shabaz123/waveminer/README.md

Wave Miner
==========

This repository contains the schematic, PCB Gerber files, bill of materials and code for the Wave Miner Digital Signal Processor (DSP) board, which connects to the Raspberry Pi (Pi 4 was tested; other versions can work with a small code change; the addresses called PERIPHERAL_BASE or I2C_BASE in the i2cfunc.h file needs to be modified if you're not using a Pi 4).

For simplicity this project uses a ready-made low-cost (about $20 USD) DSP module from AliExpress, it is the green board on the left in the photo below. The remainder parts and blue circuit board should cost less than $30, and assembly time is just a few hours. It can be assembled using a basic soldering iron (it is all through-hole soldering mostly, and a few large surface-mount parts that need no special tools).

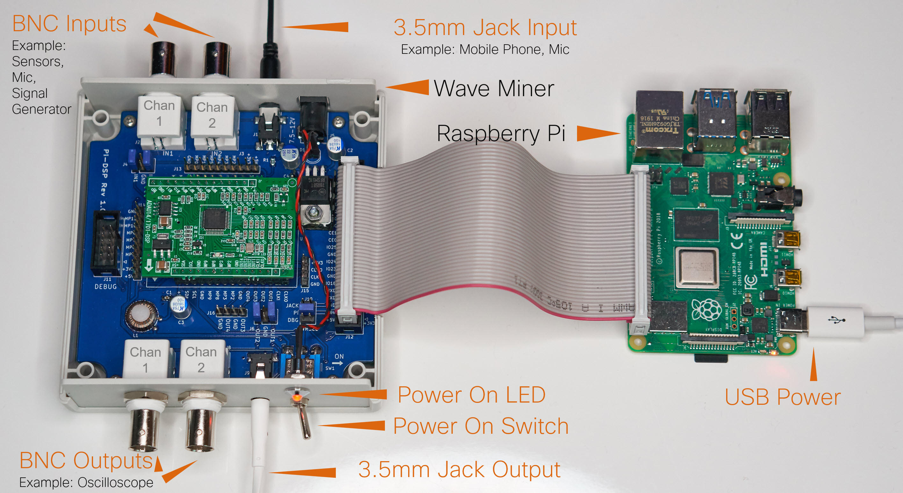
[picture p1: assets/waveminer-pi-annotated.jpg]


What are some example use-cases for it?
---------------------------------------

Use Wave Miner for examinining signals from sensors (vibration sensors, microphones etc), measuring them and cleaning them up. Wave Miner is low-cost enough that it could be permnanently installed for a particular use-case (e.g. constantly processing sensor signals) or it can be used as an instrument for evaluating new sensor data and deciding how to work with it. You can also use Wave Miner to generate signals, including noise, in order to simulate scenarios, or generate tones or other signals for other project development purposes. Since Wave Miner can handle the audio spectrum range, Wave Miner can also be used for audio effects and processing. Use Wave Miner for pulling weak signals out of noise using lock-in amplifier capability, or use Wave Miner to make impedance measurements.

What can you do with the Wave Miner?
------------------------------------

Here are some examples; all of these are possible with the hardware and software. Reboot the Wave Miner card (toggle the power button left and then right) after using the **eeload** command:

(1) Sine Wave Generation at (say) 1000 Hz, with an amplitude of 1.0 (1.0 corresponds to 2.6 Vp-p):

    ./eeload -p tone_app.bin
    ./dspgen -f 1000 -a 1.0

(2) Notch filter at (say) 50 Hz:

    ./eeload -p notch4.bin
    ./notch -n 50

(3) Bandpass filter a signal, between 300 Hz and 3000 Hz:

    ./eeload -p filter6.bin
    ./filter -b1 300 -b2 3000

(4) High-pass filter a signal, at 60 Hz:

    ./eeload -p filter6.bin
    ./filter -h 60

(5) Low-pass filter a signal, at 500 Hz:

    ./eeload -p filter6.bin
    ./filter -l 500

(6) Very experimental lock-in amplifier, to identify weak signals

    ./eeload -p lia.bin

The stimulus signal is generated at Output channel 1, and the input is at the channel 1 input connection. The lock-in amplifier result is a tone output for now, audible on output channel 2. The tone increases as the signal is detected by the lock-in amplifier.

(7) Frequency response and RMS measurements:

    ./eeload -p freqresp.bin
    
and

    ./eeload -p rms.bin

See the [webdsp project](https://github.com/shabaz123/webdsp) which uses the Wave Miner hardware. It describes how to view the frequency response and RMS values on a web page.

(8) Impedance Measurement at 1000 Hz (frequency selection #3) using display mode #1 (parallel Rp Rc)

    ./eeload -p imp.bin
    ./imp -i 3 -d 1

The impedance measurement software currently only supports 100, 120, 1000 and 10000 Hz (selected using -i1 to -i4 respectively) and one display mode (selected using -d 1). The stimulus signal is generated on the first output port on the Wave Miner, and the measurement is made on the first and second input ports (in-phase real, and 90 degree out-of-phase imaginary respectively). External hardware may be required to buffer the stimulus and to amplify the measurement signals, depending on the range of impedance to be measured. Currently there is no calibration capability, so some values in the code may need to be adjusted. 

Example output:

    pi@raspberrypi:~/development/waveminer$ ./imp -i 3 -d 1 -m
    Phase               (phi) : -0.494 rad
    Impedance             (Z) : 8.248 ohm
    Reactance             (X) : -4.443 ohm
    Resistance            (R) : 6.948 ohm
    Parallel Resistance  (Rp) : 9.369 ohm
    Parallel Capacitance (Cp) : 9.153 uF    

Ordering the PCB
----------------

The zip file prefixed **export-gerber-pi-dsp** can be uploaded to popular PCB manufacturer sites such as JLC PCB or Elecrow, for an instant quote. It shouldn't cost more than about $5 (not including shipping charges). NOTE: It's recommended to use the latest export-gerber-pi-dsp-rev1_1.zip file, not the older file. There are three main differences: (1) A pin header is added for forcing the EEPROM to be Write-Enabled; this is useful when using an external EVAL-ADUSB2EBZ debug tool; you can leave the jumper removed if you're not using that. (2) cleaned up the top-layer copper fill slightly, (3) Improved the silkscreen with larger text. The schematic and bill of materials is not modified, since the only addition is the optional 2-way pin header and jumper, which, as mentioned, are only needed if you plan to use the external debug too.

Ordering the Components
-----------------------

See the wave-miner **bill-of-materials** PDF file for the parts list. A few parts (particularly the DSP board) are available from AliExpress, and the remainder can be obtained from sources such as Farnell/Newark. It is recommended that a ribbon cable with connectors pre-assembled for the Raspberry Pi is purchased from (say) Adafruit, unless you're familiar with how to attach insulation displacement connectors (IDC) to the ribbon cable. Note that the cable is essential, it is not possible to plug the board directly on top of the Pi like 'Pi HAT' cards.

It is also useful to have one BNC-to-BNC cable, and one cable with stereo 3.5mm plug on each end, for experimenting with the Wave Miner.

You will also need a Raspberry Pi. A Pi 4 was tested. It is possible to use a Pi 3 variant, but a code change will be required. No code change is needed if a Pi 4 is being used.

Building the Wave Miner
-----------------------

Nearly all parts are through-hole, so it is easy to solder, since the main part (the DSP module) is ready-made. The few surface mount parts are large and mostly optional. The ferrite choke is hand-wound, but if you don't have the parts (ferrite core and ~ 0.2mm diameter enamelled copper wire) then you could just put a wire short on the PCB.

Plug four jumpers to allow the two channels of input and two channels of output signals to get to the connectors. Plug a fifth jumper to select the power source (for instance select the Pi setting, so that the Pi powers the Wave Miner board).

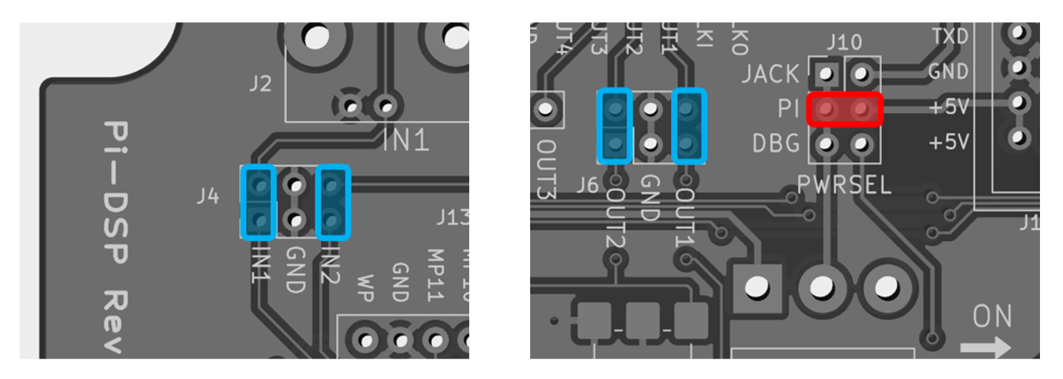
[picture p2: assets/pi-dsp-jumpers.png]


Connecting the Wave Miner to the Pi
-----------------------------------

With both the Wave Miner board and the Pi Unpowered, connect the ribbon cable between the Wave Miner and the Pi. You can plug the jumper into the Wave Miner so that the board will be powered from the Pi. Now you can power up the Pi.

Pi Pre-Requisites
-----------------

If you don't have a user account called **pi** (some recent Pi OS builds no longer have a pi user by default) then create a pi user account before proceeding, because some paths in the code are hard-coded for the pi user. You can manually modify the paths, but it is easier to just use a pi user for now.

Ensure, by typing **raspi-config** in a command prompt, that the **I2C** capability on the Pi is enabled. 

Installing the Code
-------------------

The **waveminer** software contains lots of utilities/applications.

Once you have completed the **Pi Pre-Requisites** steps above, type the following on the Pi in a command prompt to install the waveminer software:

    mkdir -p ~/development
    cd ~/development
    git clone https://github.com/shabaz123/waveminer.git
    cd waveminer
    make

Testing It
----------

You can test that the setup is working fine by running an example application:

Switch on the Wave Miner by flicking the toggle switch to the right, which is the **on** position. Then plug in headphones into the front 3.5mm stereo connector.

Type the following in a command prompt on the Pi:

    cd ~development/waveminer
    ./eeload -p tone_app.bin

Reboot the Wave Miner for the code to take effect. To perform the reboot, flick the toggle switch off and on.

Now type the following, and you should hear a continuous 220 Hz tone from the left earpiece:

    ./dspgen -a 0.1 -f 220

If you don't hear anything, you can increase the volume by increasing the **-a** parameter:

    ./dspgen -a 0.4 -f 220

Next Steps
----------

There are some partner web apps for the Wave Miner, to allow you to operate the Wave Miner directly from a web browser.

To install and use the web apps, visit https://github.com/shabaz123/webdsp

When run, the web apps will automatically call the Wave Miner code.

Creating Custom Apps
--------------------

To create your own custom DSP apps, install free-to-use SigmaStudio software. SigmaStudio uses graphical programming. 

The SigmaStudio Automotive and Generic Release SigmaStudio 64 Bit-OS Rev 4.6 is available from the [Analog Devices](https://www.analog.com/en/design-center/evaluation-hardware-and-software/software/ss_sigst_02.html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) website.

Use the software to drag-and-drop to build up the following Hardware Configuration:

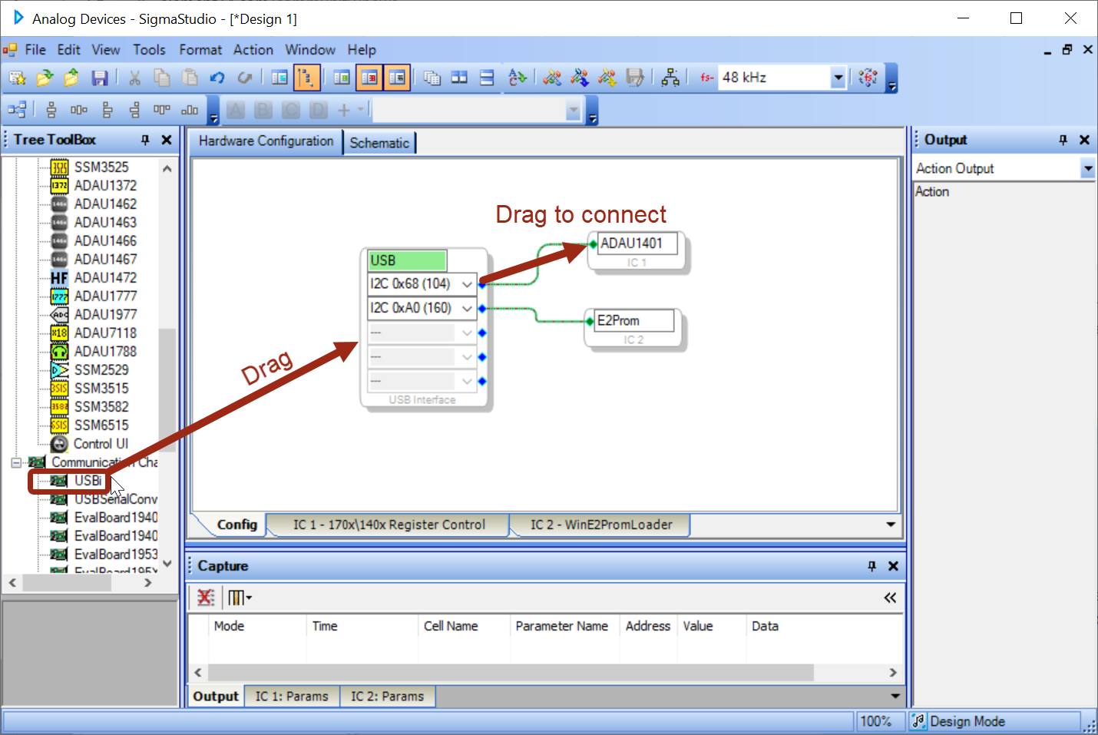
[picture p3: assets/sigma-drag.png]


Next, click on the Schematic tab and construct your desired siganl flow, again using drag-and-drop. Here is an example to generate a sine wave with configurable amplitude:

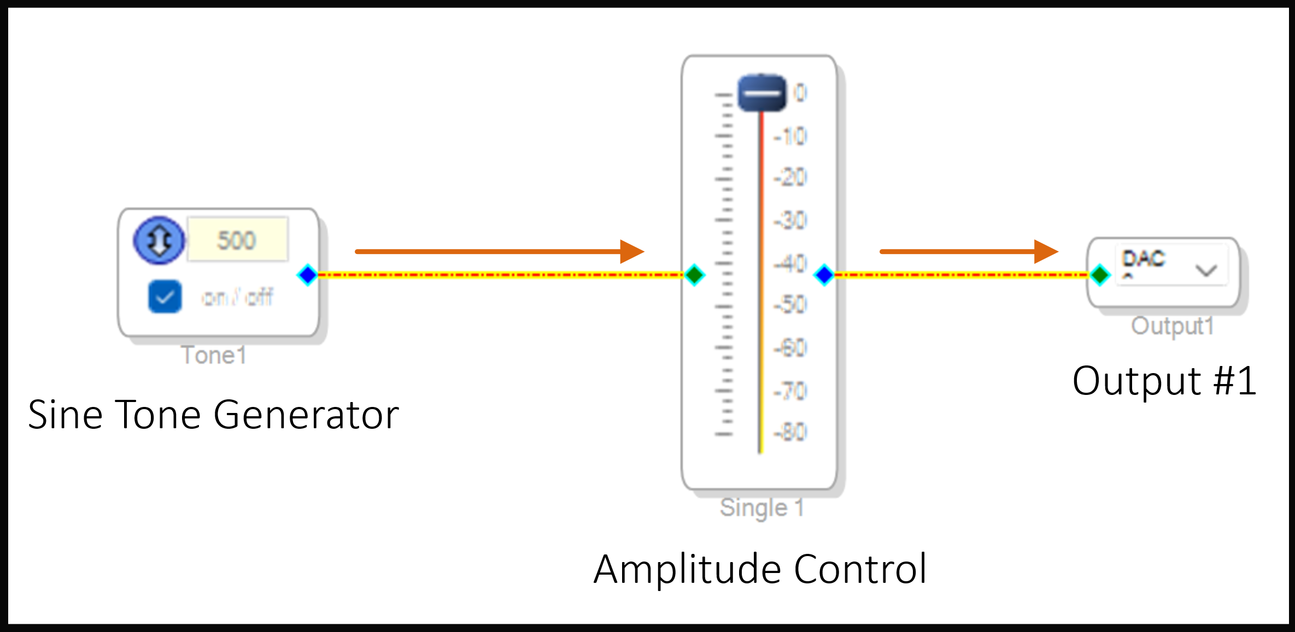
[picture p4: assets/dspgen-flow.png]


Click on the icon shown here, which is the **Link Compile Download** icon:

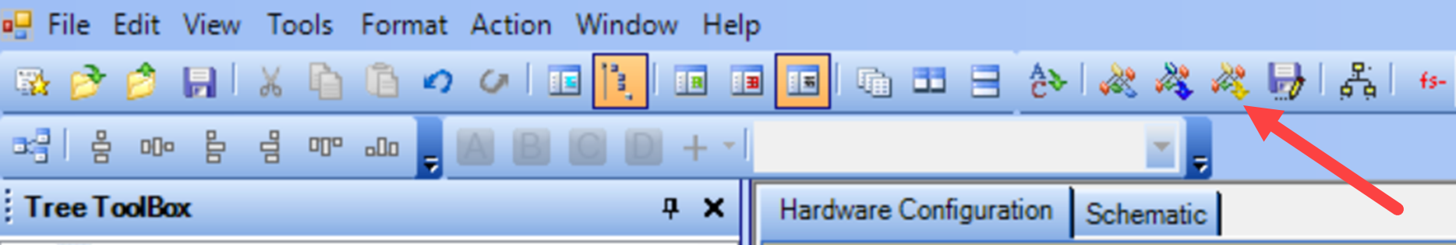
[picture p5: assets/lcc-icon.png]


You will get an error message concerning absence of USB programmer tool, but you can ignore the error. Now click back to the Hardware Configuration pane, and right-click on the ADAU1401 component which was drag-and-dropped earlier, and select **Write Latest Compilation to E2PROM**

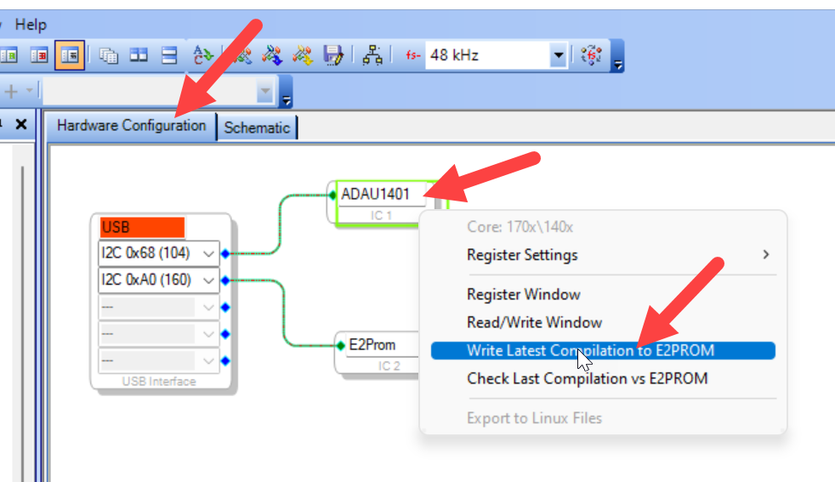
[picture p6: assets/write-eeprom.png]


Now go into the project folder, and there will be a sub-folder inside there called **xyz_IC 2** where xyz is your project name. The firmare file will be there, called **E2prom.bin**. That file can be transferred to the Pi, renamed to something more memorable, and then you can use the **eeload -p** command as shown in the examples earlier.

If you wish to use the Pi to configure the elements in the graphical flow, then click on the item in SigmaStudio and make any example modification to it, for instance change the frequency displayed inside the sine tone generation box. You should see a stream of hex bytes displayed in the lower pane in Sigma Studio; those bytes are the values that need to be sent using I2C. Refer to the **dsputil.cpp** file to see how this is done. 

Appendix 1: Using I2S Output
---------------------------------------

If you don't wish to use the analog output, and prefer digital I2S output, then you can use the pin headers and connect as follows: MP6=DATA, MP10=LRCLK, MP11=BCLK. The Sigmal Studio hardware configuration looks like this:

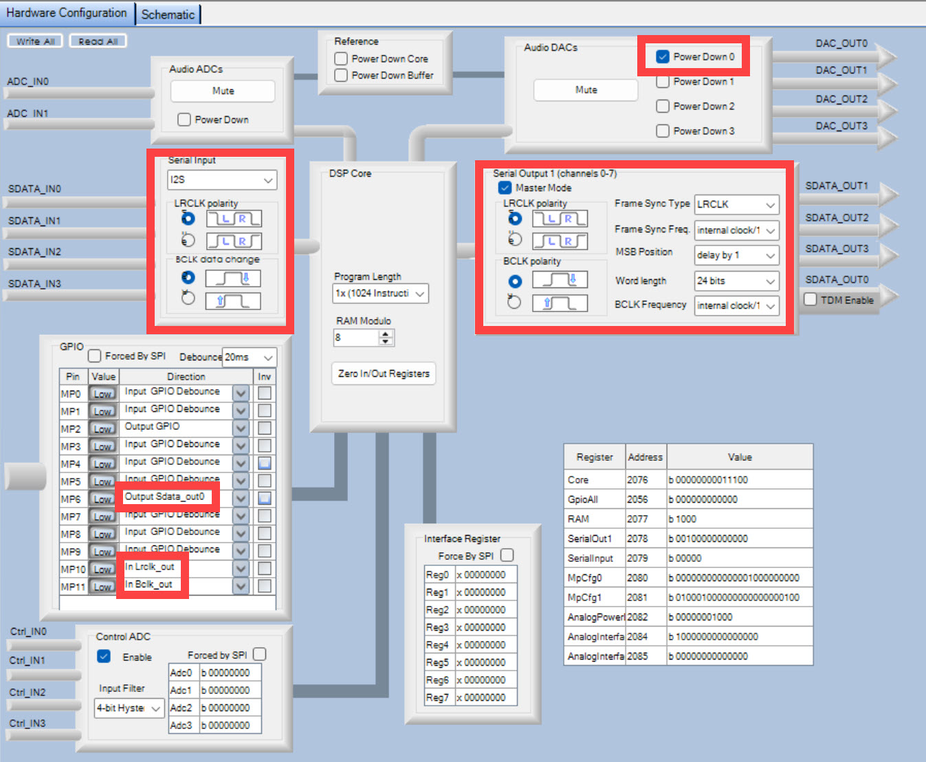
[picture p7: assets/dsp-hw-config-i2s-out.jpg]


For the DSP flow, use the output sink shown in the diagram here:

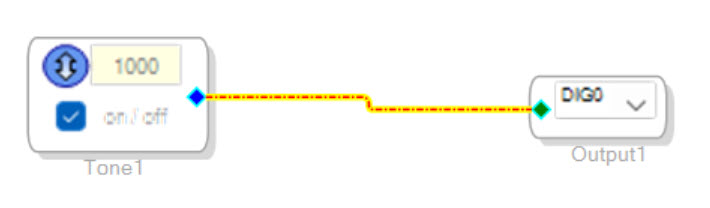
[picture p8: assets/dsp-flow-i2s-out.jpg]
