shabaz123/waveminer/wave-miner-rev-1-panel-cutouts.pdf

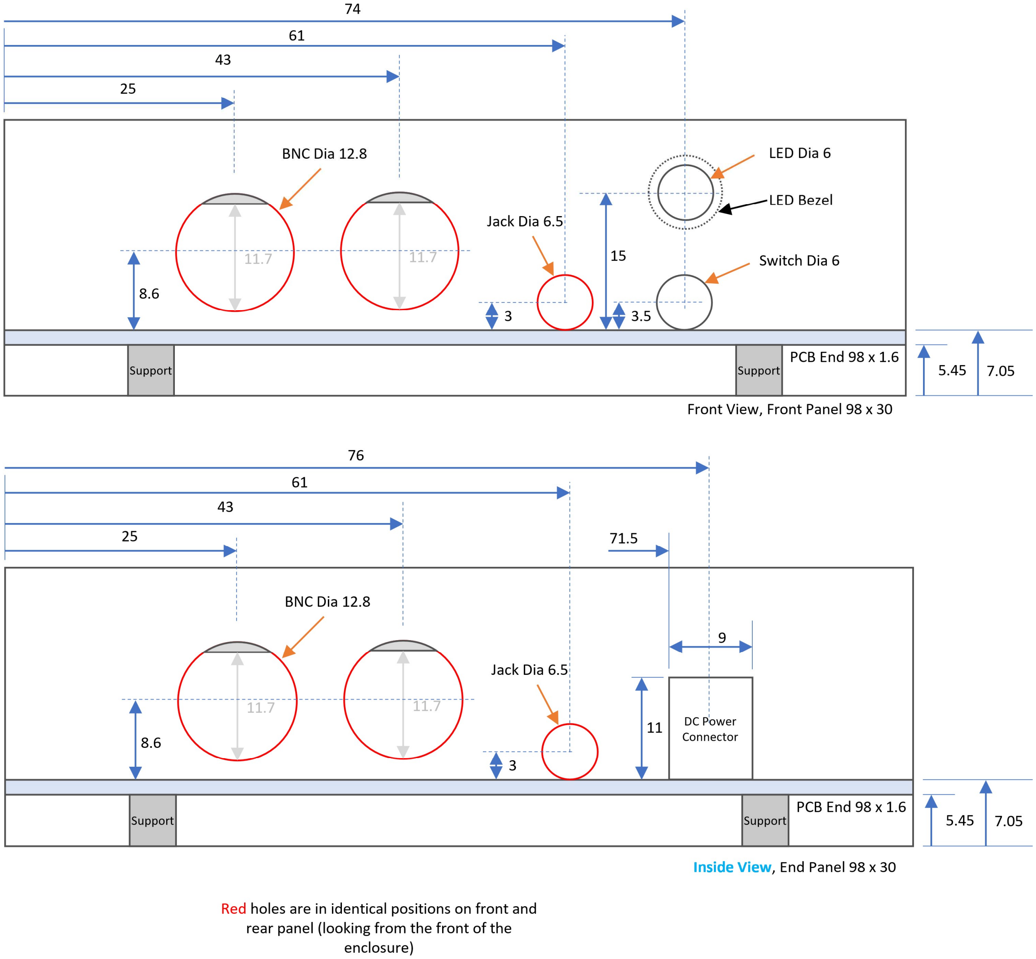
[picture p9: figure]
