shabaz123/waveminer/assets/waveminer-intro.jpg

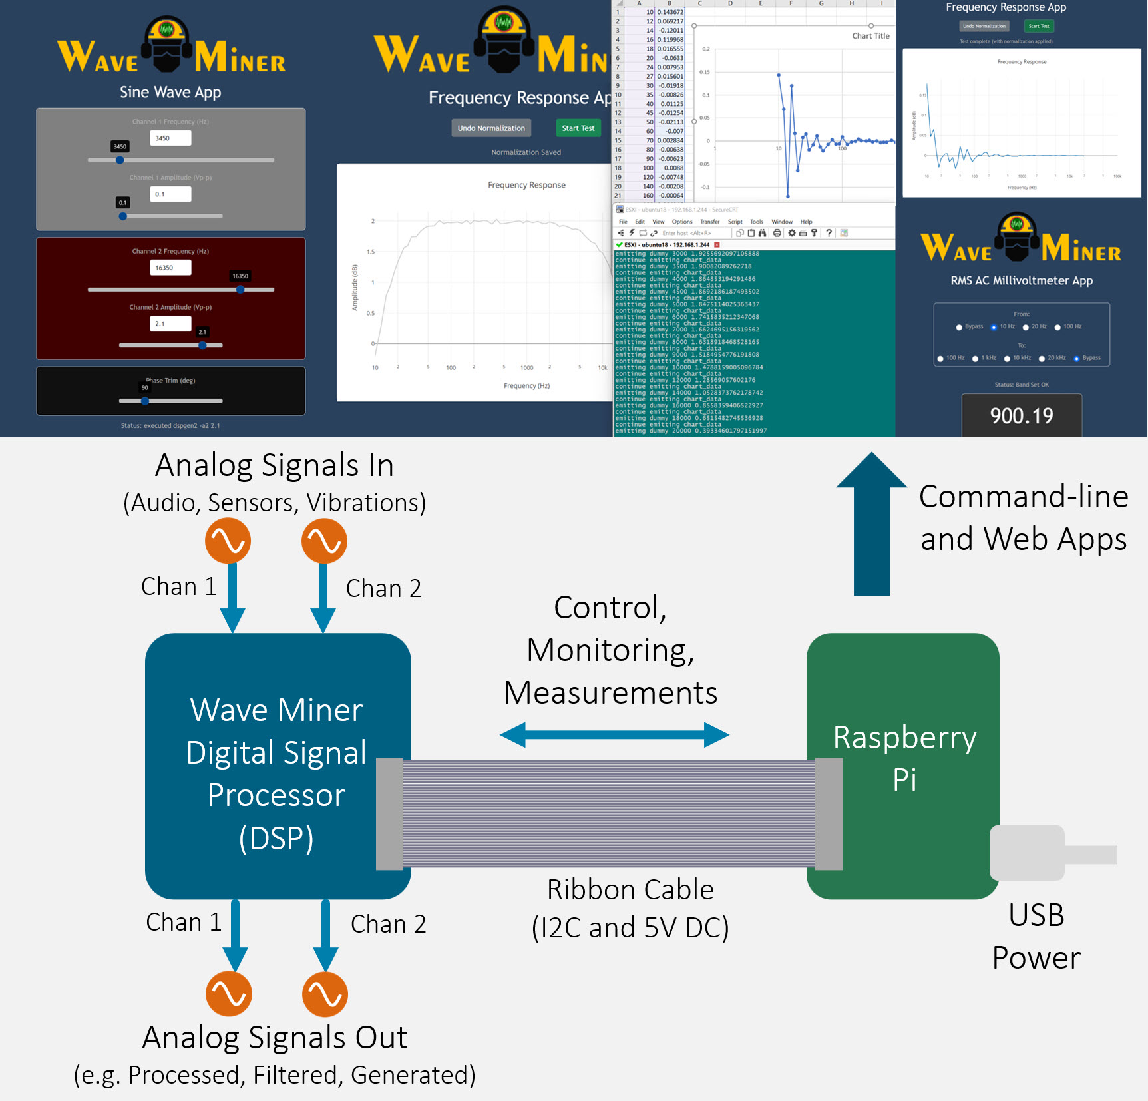
assets/waveminer-intro.jpg
