shabaz123/waveminer/assets/webdsp-example-screenshots.png

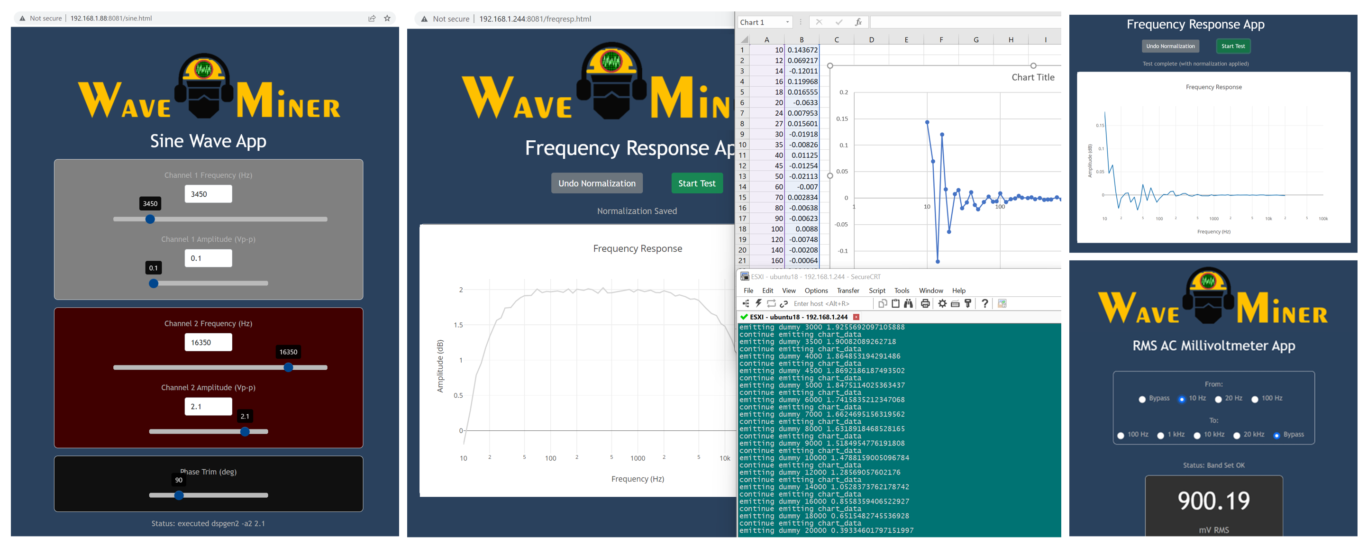
assets/webdsp-example-screenshots.png
