shabaz123/waveminer/wave-miner-rev-1-schematic.pdf

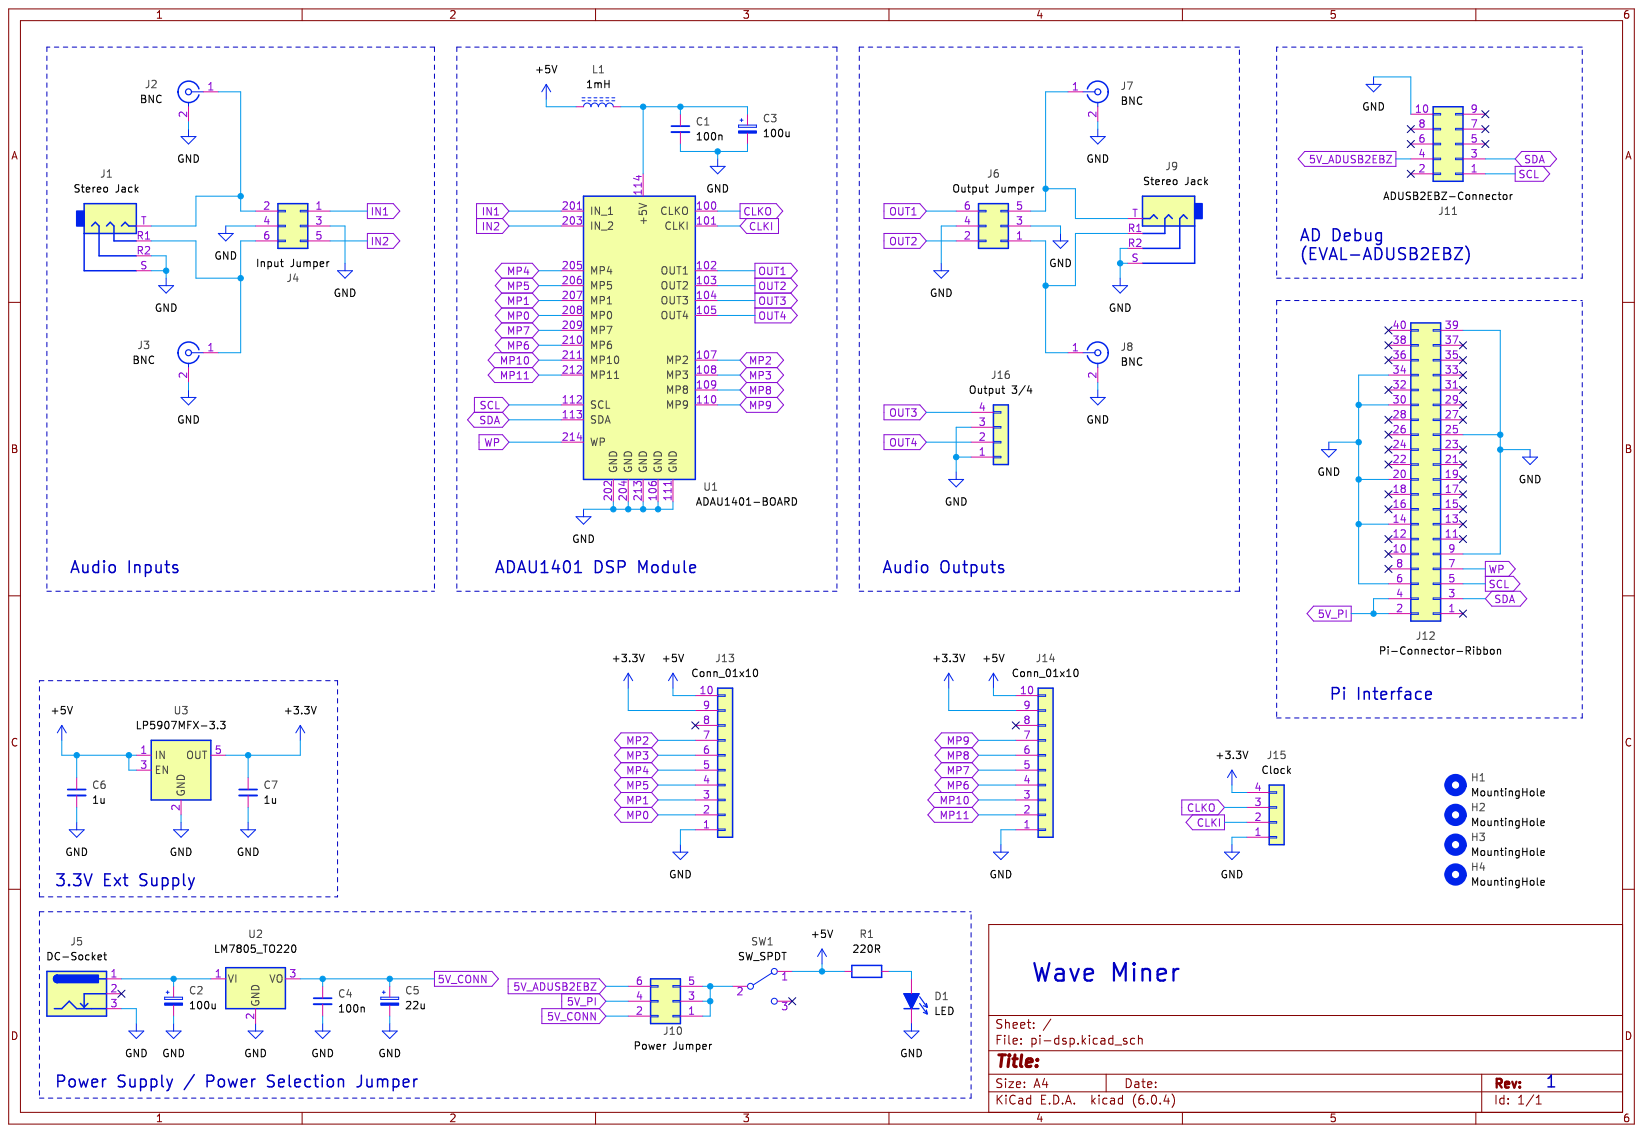
[picture p12: page 1]
