shabaz123/waveminer/lcr-test-ltspice.asc

C1: cap; 100n
R1: res; 1000
R2: res; 10
V1: voltage; SINE(0 0 1000); AC 1.37901 0
Named nets: 0, output
.ac list 1000
