shabaz123/waveminer/filter.cpp

/*****************************************************
 * filter - Filter Tool
 * rev 1 - april 2022 - shabaz
 *
 * uses filter6.bin
 * The filter tch tool can be used for applying 
 * lowpass, highpass and bandpass filters.
 * The range is 25 - 15000 Hz, in 25 Hz steps. 
 * first program the DSP board EEPROM using:
 * ./eeload -p filter6.bin
 * then power-cycle the DSP board for the EEPROM
 * to be read by the DSP.
 *
 * Example to enable a low-pass response at 300 Hz:
 *      ./filter -l 300
 * Example to enable a high-pass response at 3000 Hz:
 *      ./filter -h 3000
 * Example for bandpass 300-3000Hz:
 *      ./filter -b1 300 -b2 3000
 * Example for bandpass at 1000 Hz with 500 Hz width:
 *      ./filter -b 1000 -w 500
 * the above is the same as:
 *      ./filter -b1 750 -b2 1250
 *****************************************************/

// includes
 #include <stdio.h>
 #include "options.h"
 #include "dsputil.h"

// defines
#define LOW 0
#define HIGH 1

// consts used by notch.bin
const int FILTER_NODE = 0x0000; // address of first filter node

// each row contains coeff b0, b1, b2, a1, a2:
const double butterlowcoeff[600][5] = {
    { 2.671118191244215E-06, 5.342236382488430E-06, 2.671118191244215E-06, -1.995372005171181E+00, 9.953826896439464E-01 }, /* 25 Hz */
    { 1.065983454073827E-05, 2.131966908147653E-05, 1.065983454073827E-05, -1.990744059505048E+00, 9.907866988432112E-01 }, /* 50 Hz */
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
    { 4.170258832428437E-01, 8.340517664856875E-01, 4.170258832428437E-01, 4.590332176920862E-01, 2.090703152792886E-01 }, /* 14975 Hz */
    { 4.181633457618990E-01, 8.363266915237979E-01, 4.181633457618990E-01, 4.629380252910409E-01, 2.097153577565549E-01 }  /* 15000 Hz */
};
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
