shabaz123/waveminer/options.cpp

#include <string>
#include "options.h"

char* getCmdOption(char ** begin, char ** end, const std::string & option)
{
    char ** itr = std::find(begin, end, option);
    if (itr != end && ++itr != end)
    {
        return *itr;
    }
    return 0;
}

bool cmdOptionExists(char** begin, char** end, const std::string& option)
{
    return std::find(begin, end, option) != end;
}
